Dearmoments/28_-/源码/stm32/readme.txt

本实验将实现如下功能：本实验为基于UCOSIII操作系统的STemWin的移植，我们使用UCOSII来为STemWin提供系统时钟，建立一个任务来处理触摸屏。本实验通过移植官方的Demo来测试基于UCOSII的STemWin移植是否成功，本实验兼容2.8，3.5，4.3寸屏幕。

注意：本实验使用了UCOSII操作系统，使用了触摸屏！

            	广州市星翼电子科技有限公司

                电话：020-38271790

                传真：020-36773971

	       	购买：http://shop62103354.taobao.com

                      http://shop62057469.taobao.com

                公司网站：www.alientek.com

         	技术论坛：www.openedv.com
