Dearmoments/28_-/方案说明/方案说明.md

这个题主要难度在于测上升沿时间，用窗口比较器测的话进度难以保证，一是测幅会有误差，测幅误差会导致窗口电压存在误差，而比较器本身也不是理想比较器，这一系列误差、非理想情况造成的误差会积累，导致最后精度难以保证。这个方案对制作要求太高。。

我们这次用的方法是：ADC等效采样、脉冲的上升沿，根据上升沿的几个数据点求出上升沿斜率，根据脉冲幅值和斜率求出上升时间，这个方法还算靠谱，不”校准“的情况下精度即可达到要求。

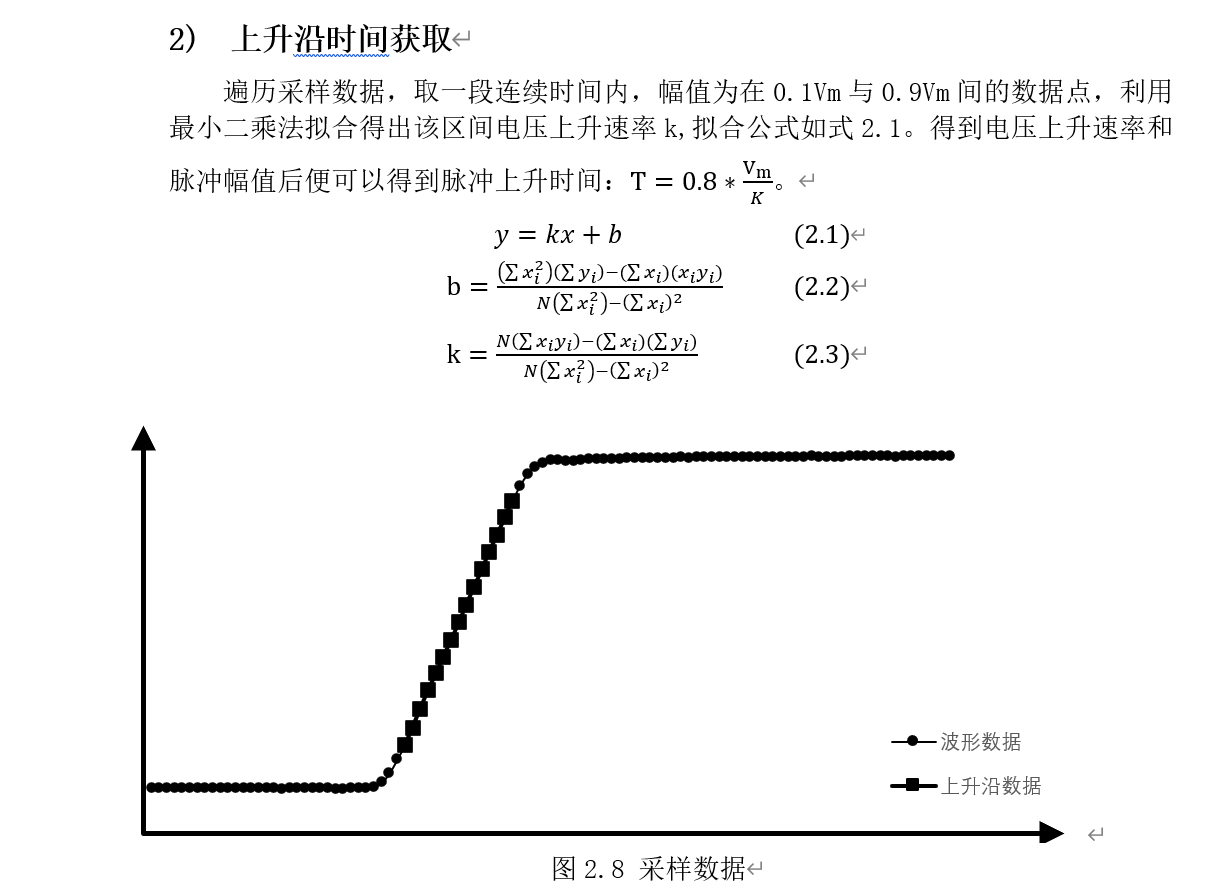
[picture p1: 方案说明/方案说明.assets/image-20200614181531141.png]
