Dearmoments/28_-/总结.docx

幅值测量：统计，取平均，会使结果稳定很多，几乎不跳动

上升时间测量：等效采样，拟合上升沿，求上升速率，再根据幅值算出上升时间，会准很多
