Dearmoments/28_-/图片/IMG_20190709_141804.jpg

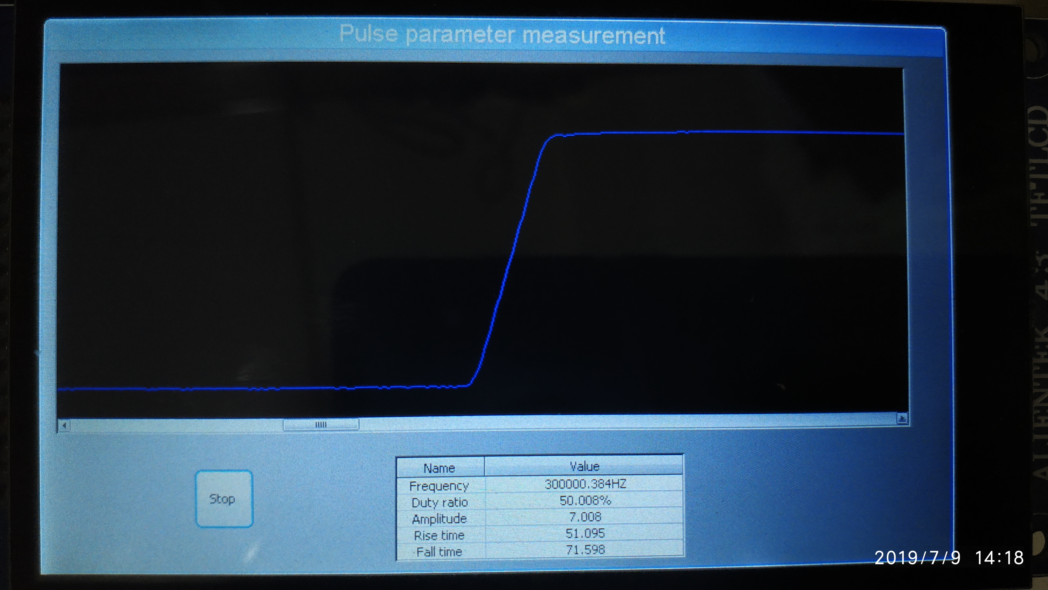
图片/IMG_20190709_141804.jpg
