Dearmoments/28_-/文档/脉冲参数测量硬件结构图-V1.1.pdf

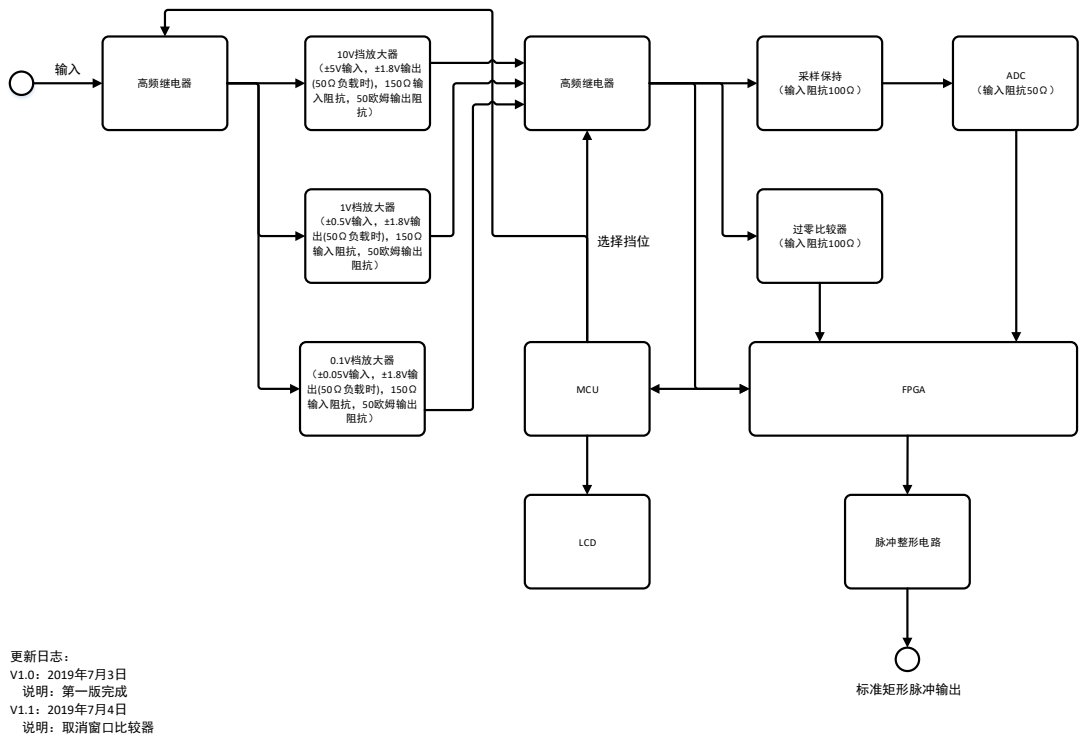
[picture p3: page 1]
10V挡放大器 （±5V输入，±1.8V输出 (50Ω负载时)，150Ω输 入阻抗，50欧姆输出阻 抗）; 1V档放大器 （±0.5V输入，±1.8V输 出(50Ω负载时)，150Ω 输入阻抗，50欧姆输出 阻抗）; 0.1V档放大器 （±0.05V输入，±1.8V输 出(50Ω负载时)，150Ω 输入阻抗，50欧姆输出 阻抗）; 高频继电器; 采样保持; （输入阻抗100Ω）; ADC （输入阻抗50Ω）; 过零比较器 （输入阻抗100Ω）; MCU; FPGA; LCD; 脉冲整形电路; 选择挡位; 标准矩形脉冲输出; 更新日志： V1.0：2019年7月3日 说明：第一版完成 V1.1：2019年7月4日 说明：取消窗口比较器
