Dearmoments/28_-/文档/脉冲参数测量硬件结构图-V1.2(最终版).pdf

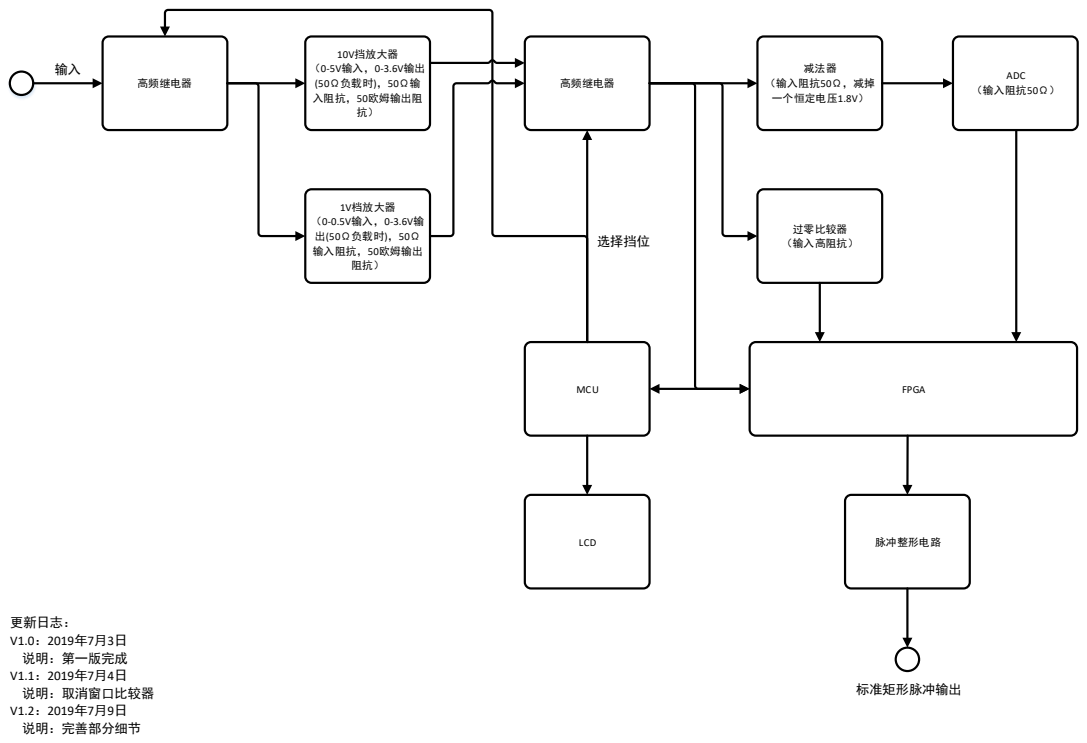
[picture p4: page 1]
10V挡放大器 （0-5V输入，0-3.6V输出 (50Ω负载时)，50Ω输 入阻抗，50欧姆输出阻 抗）; 1V档放大器 （0-0.5V输入，0-3.6V输 出(50Ω负载时)，50Ω 输入阻抗，50欧姆输出 阻抗）; 高频继电器; 减法器 （输入阻抗50Ω，减掉 一个恒定电压1.8V）; ADC （输入阻抗50Ω）; 过零比较器 （输入高阻抗）; MCU; FPGA; LCD; 脉冲整形电路; 选择挡位; 标准矩形脉冲输出; 更新日志： V1.0：2019年7月3日 说明：第一版完成 V1.1：2019年7月4日 说明：取消窗口比较器 V1.2：2019年7月9日 说明：完善部分细节
