Dearmoments/28_-/原理图/高速AD/PCB_Project/PCB_Project.pdf

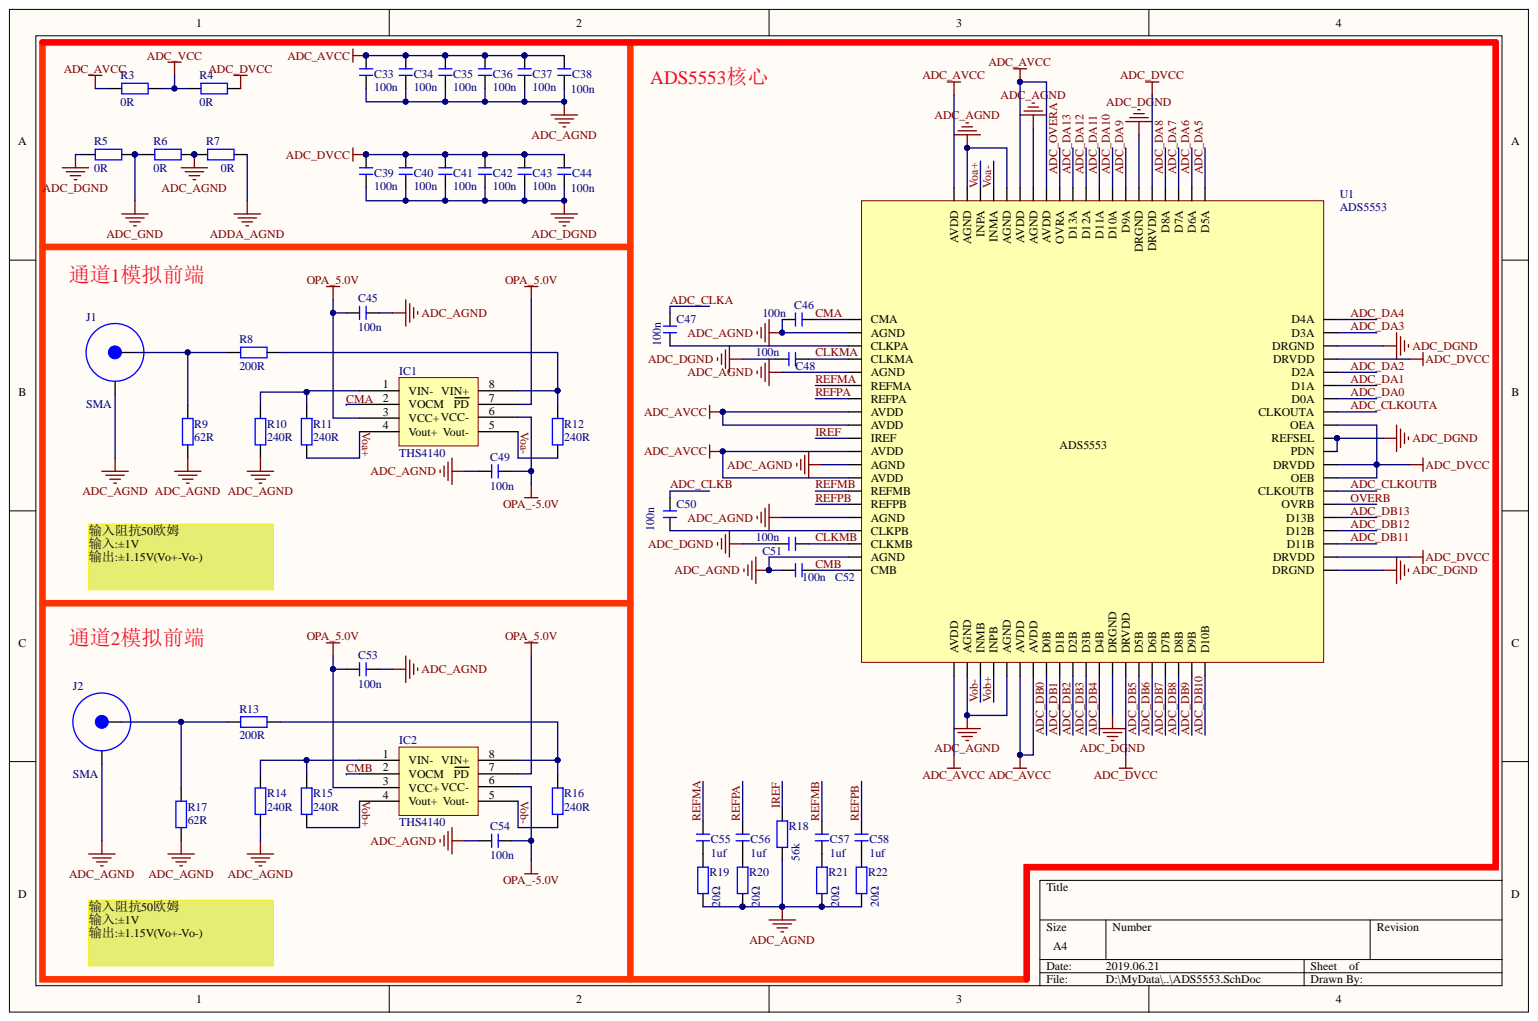
[picture p5: page 1]

CMB | VOCM 2

VCC+ 3

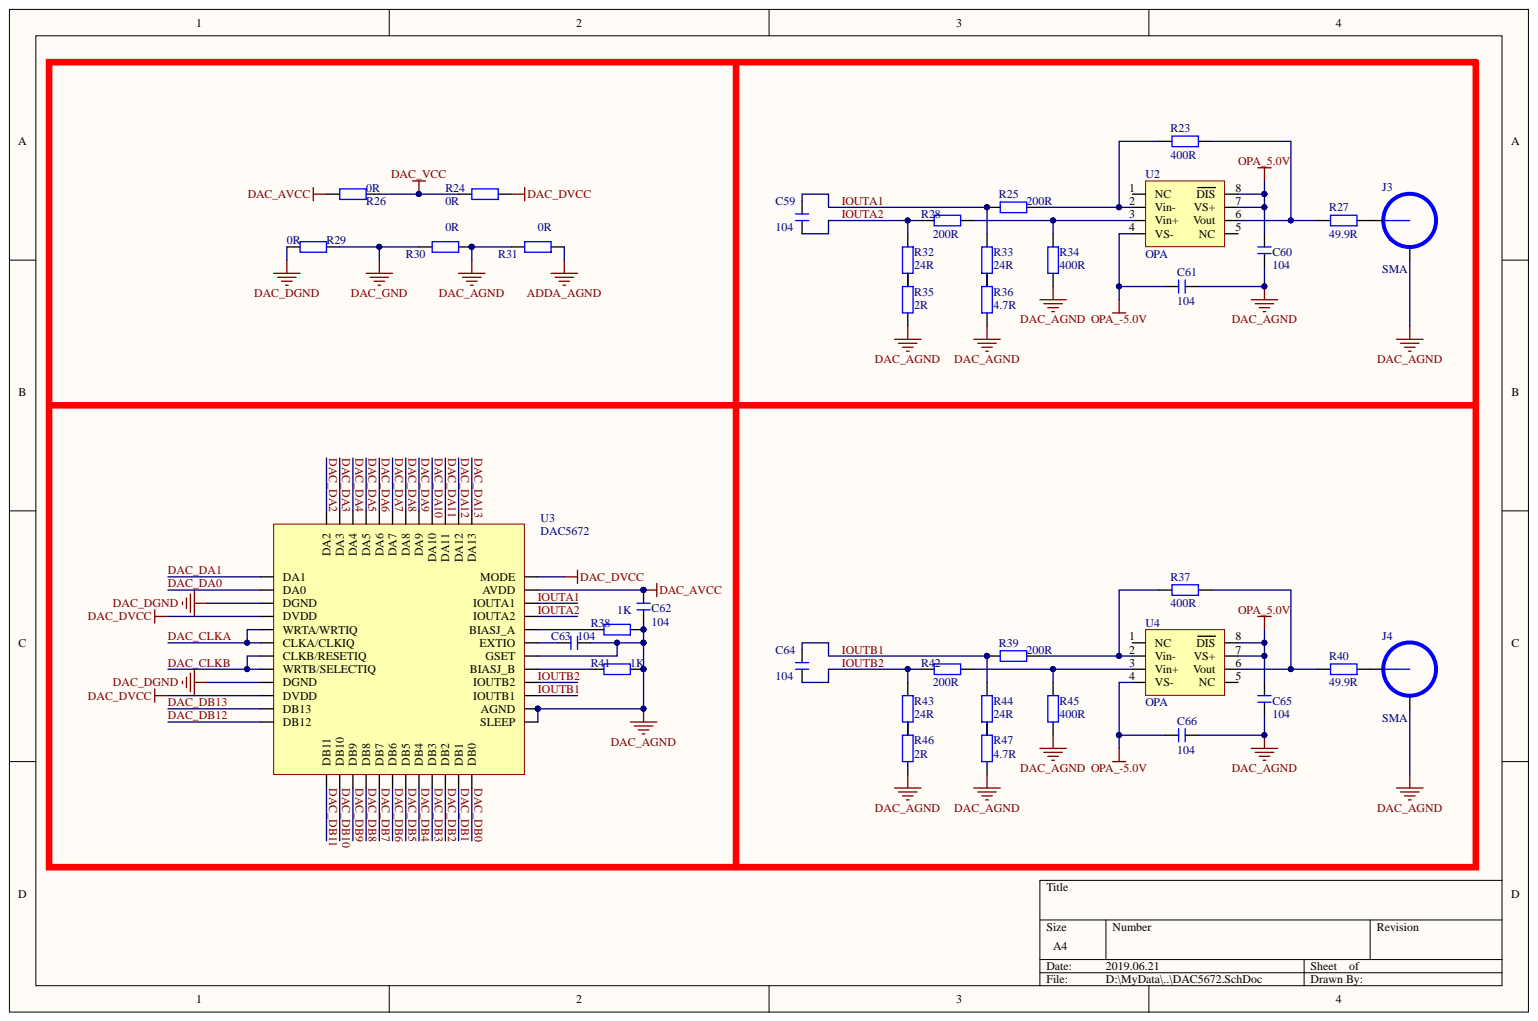
[picture p6: page 2]

DAC_VCC 0R | R23

U2 | | OPA_5.0V

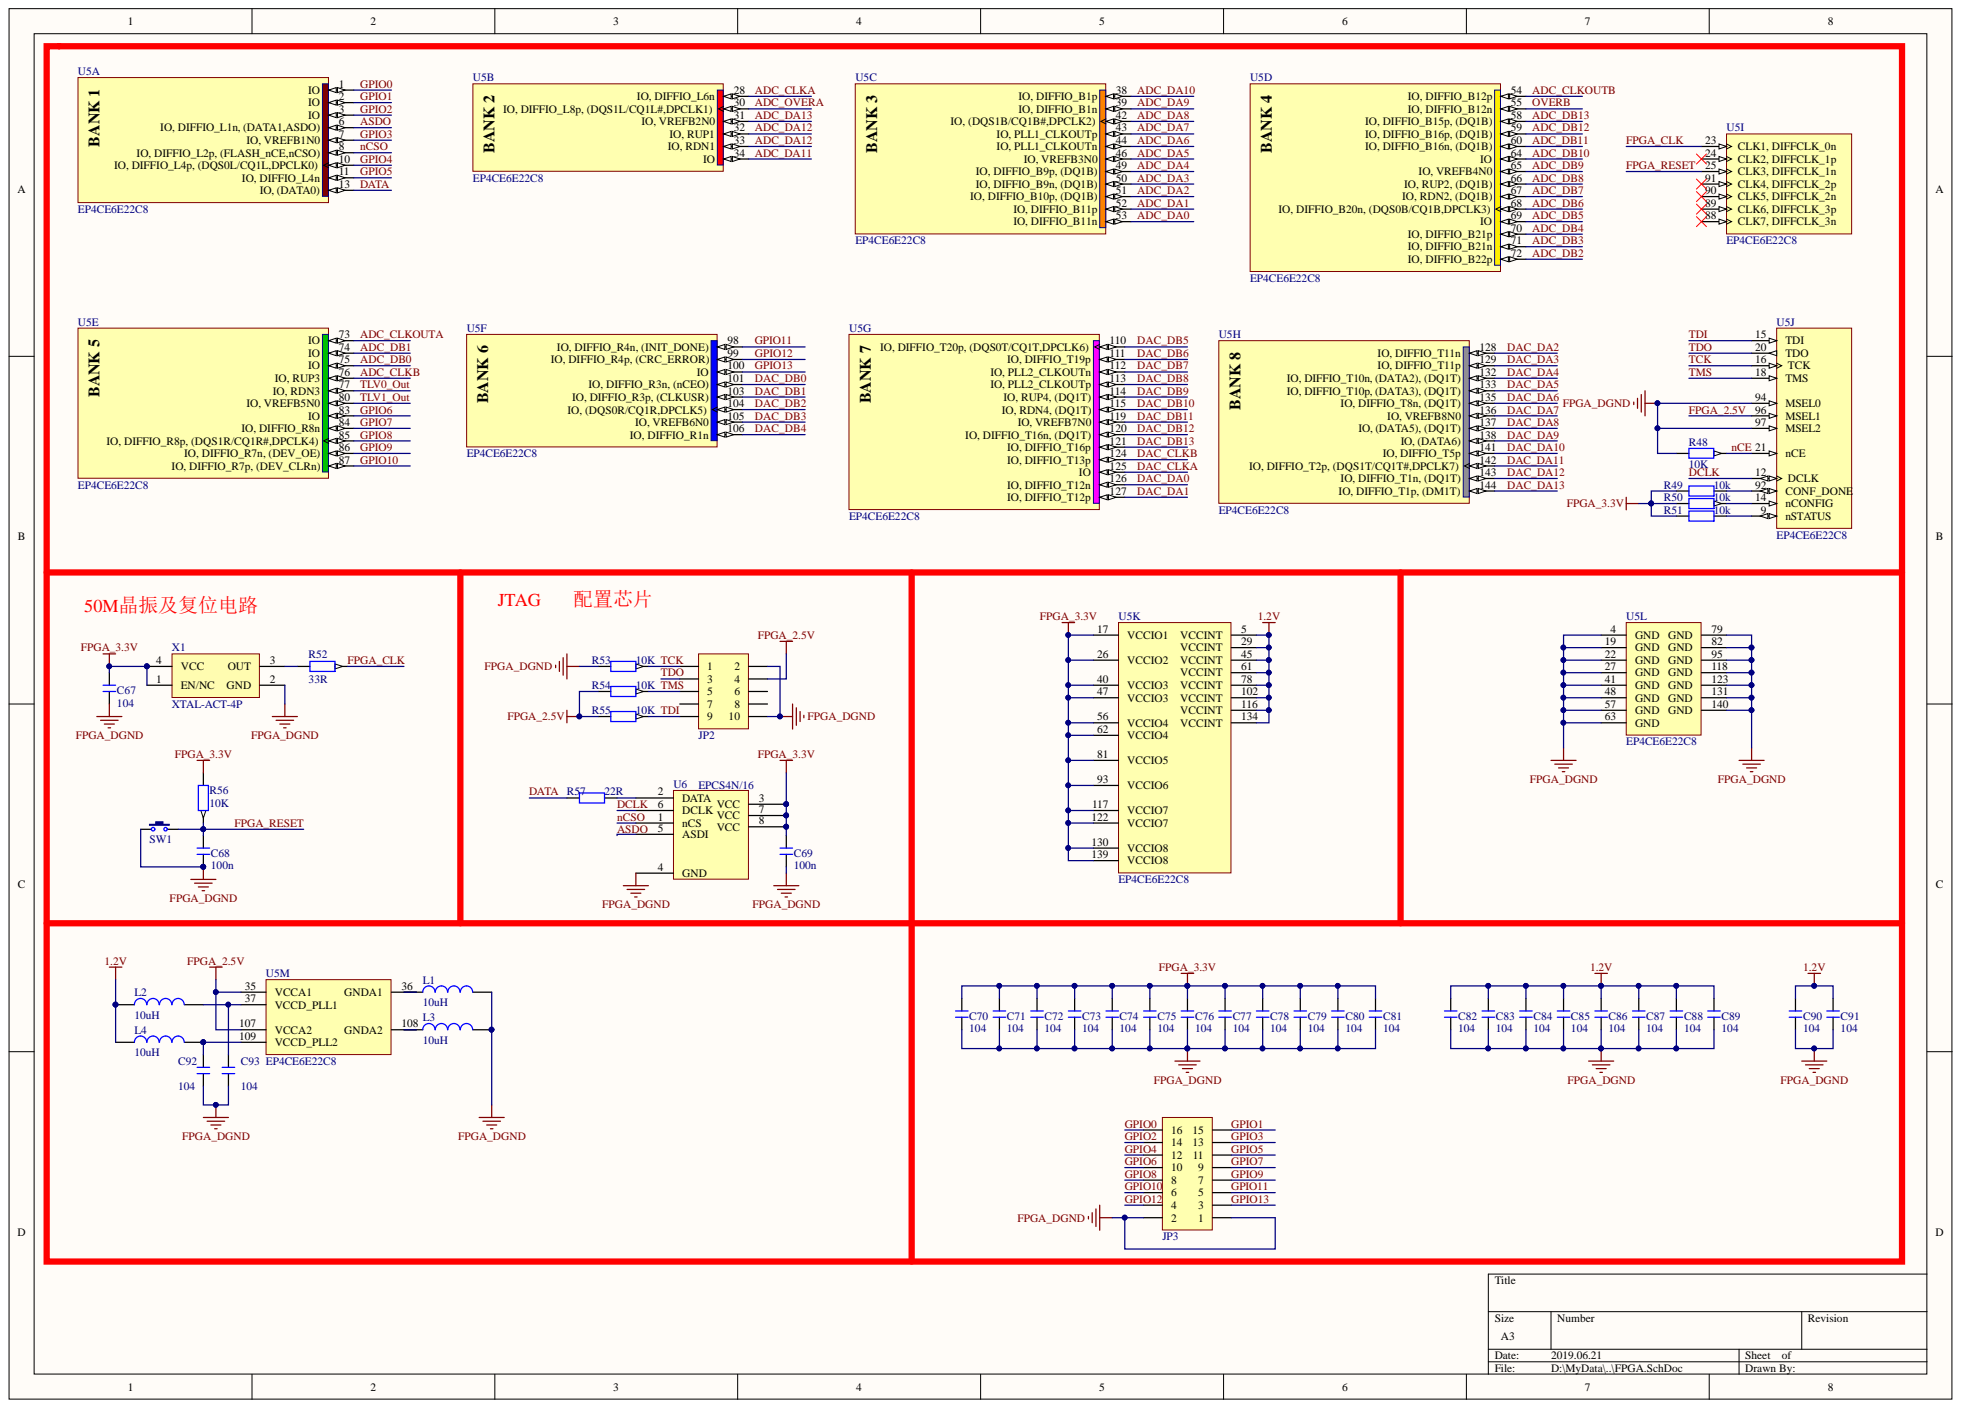
[picture p7: page 3]

VCCD_PLL1 37 VCCA2 107

VCCD_PLL2 109

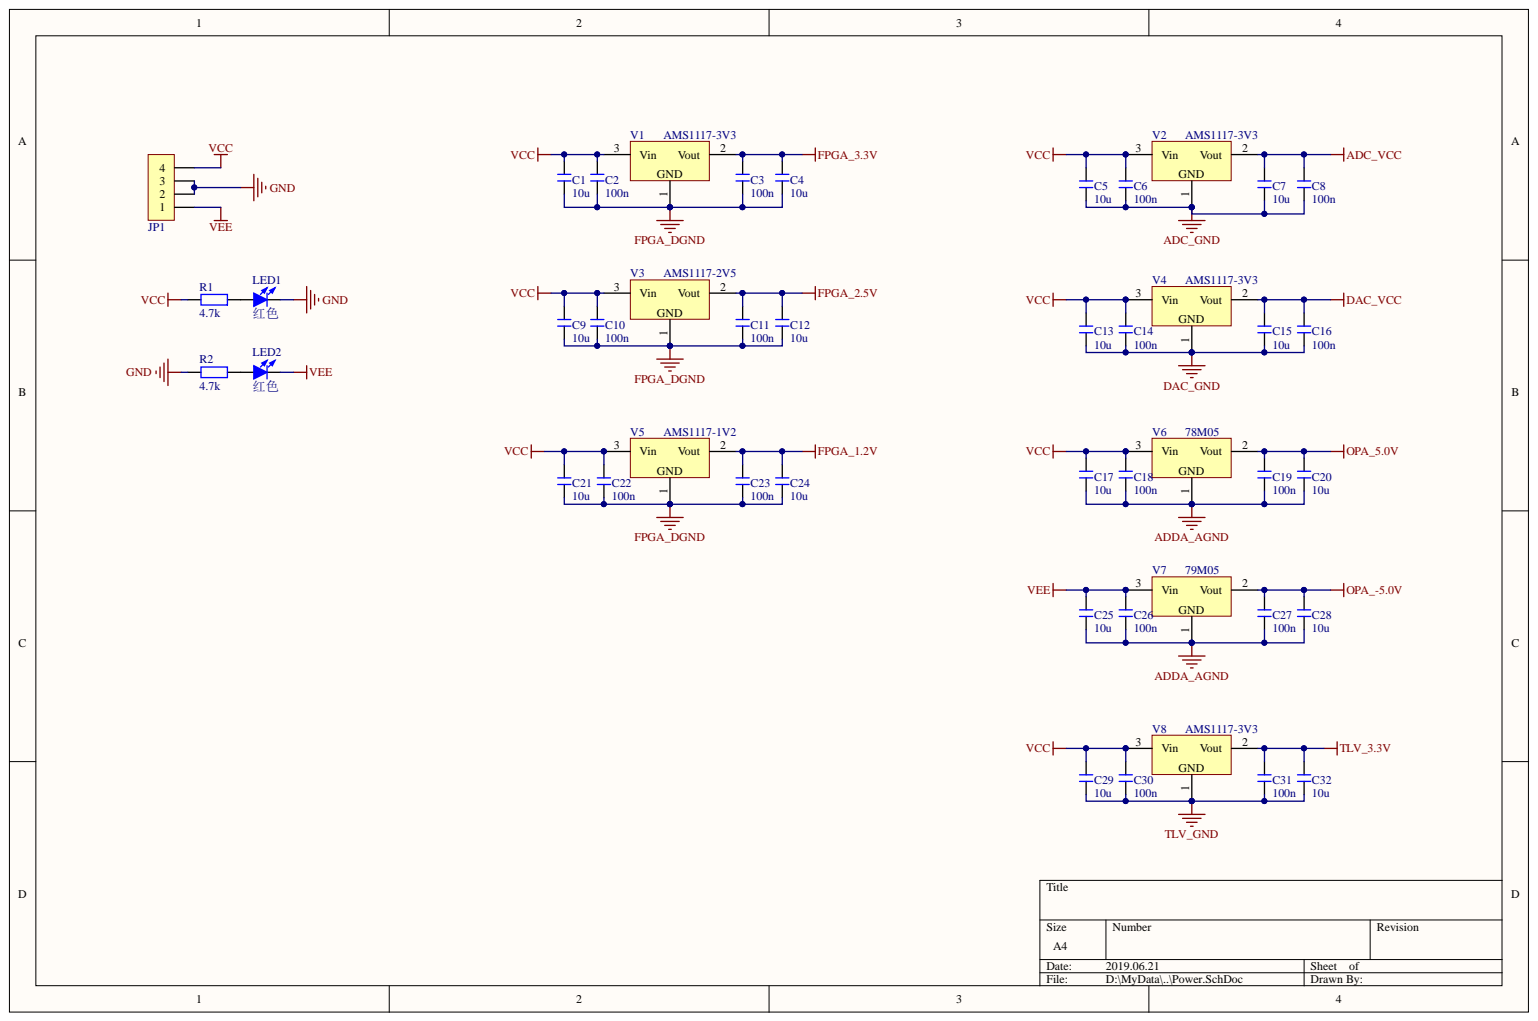
[picture p8: page 4]

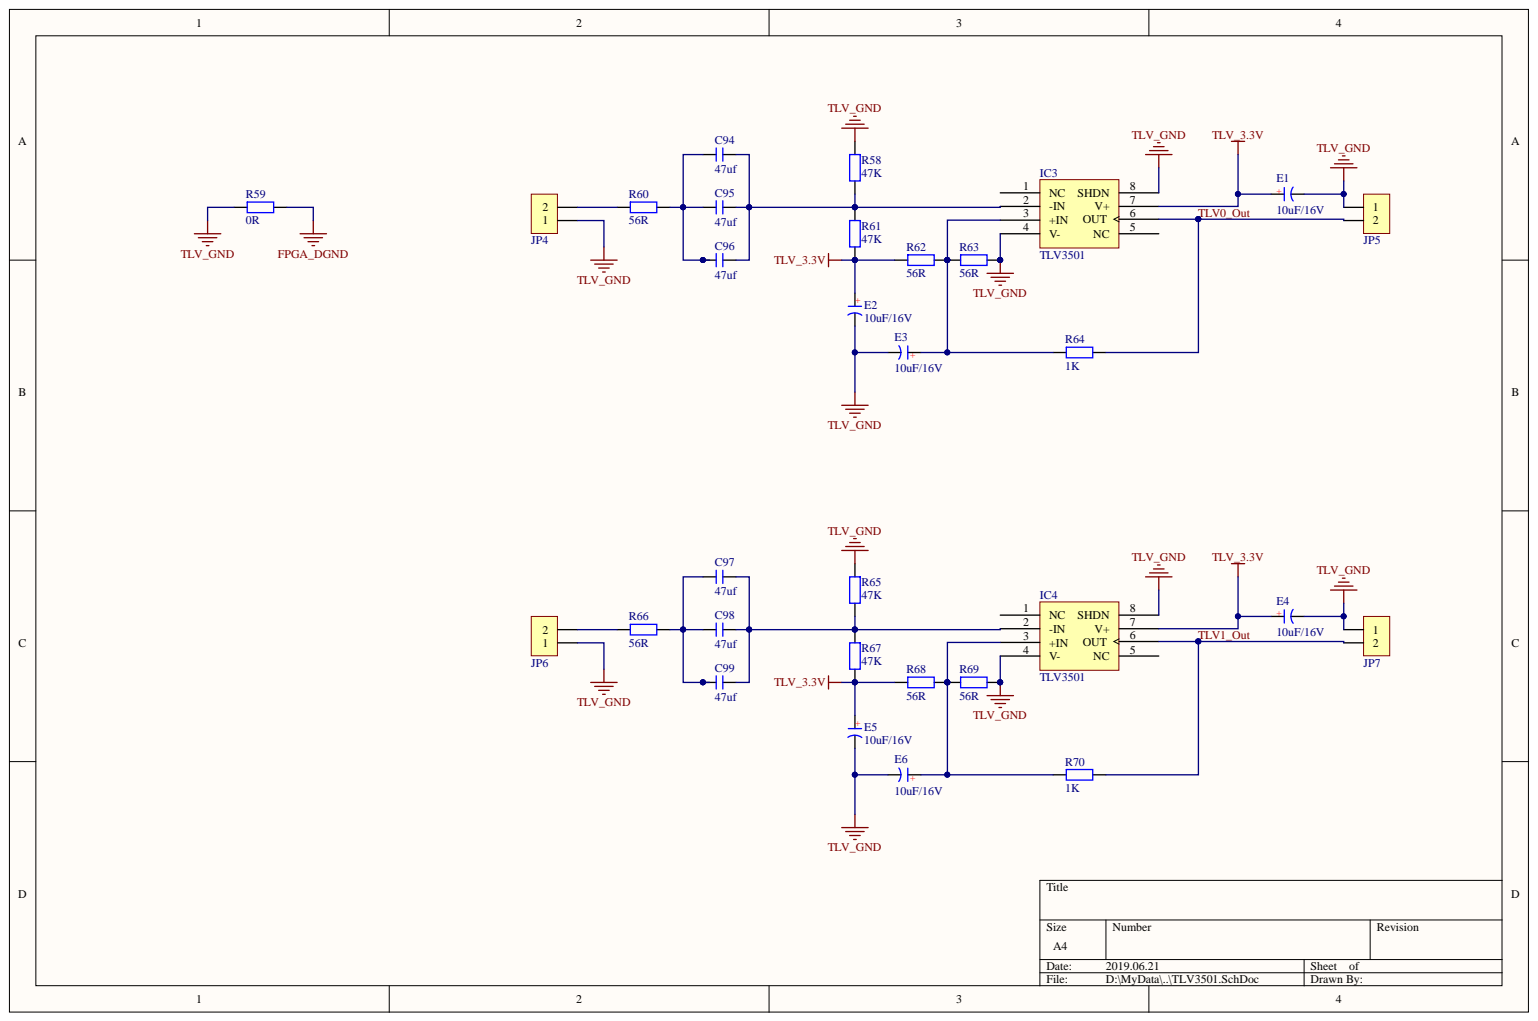
[picture p9: page 5]

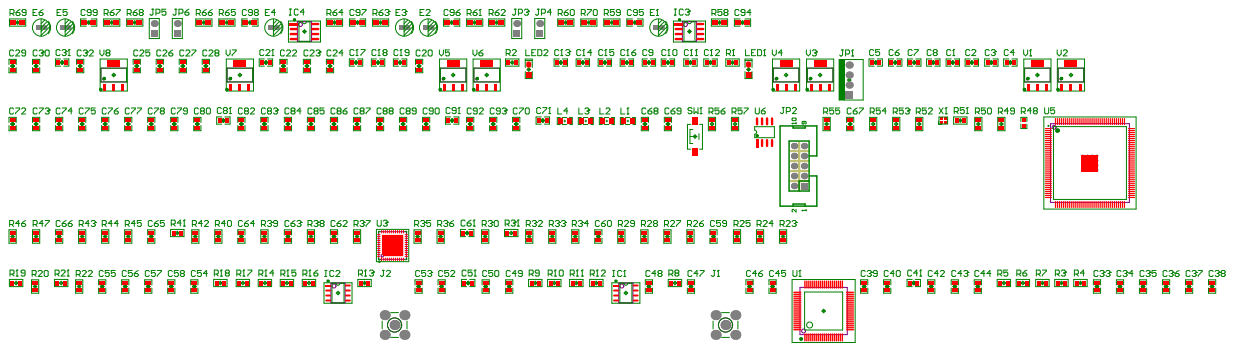
[picture p10: page 6]
