Dearmoments/28_-/原理图/ARE134H_Project/123.pdf

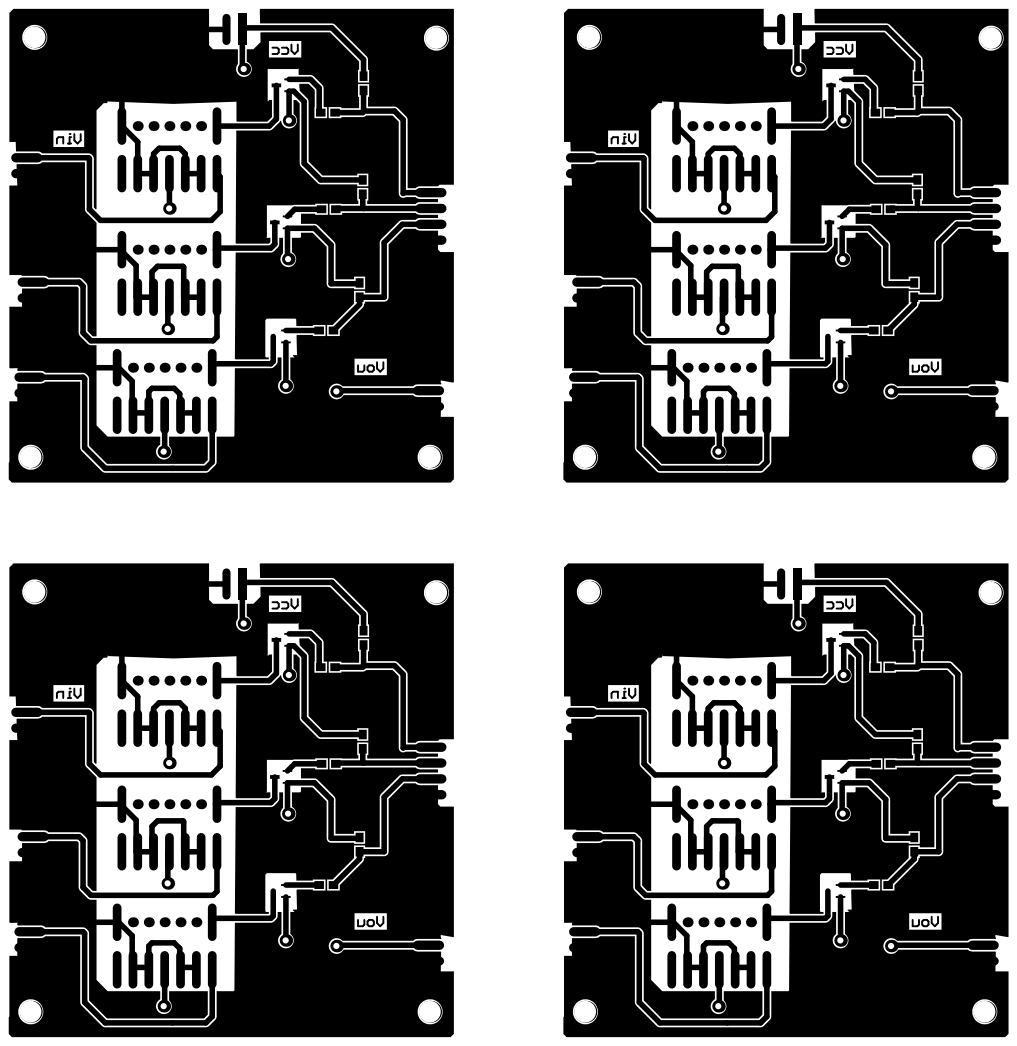
[picture p11: page 1]
