Dearmoments/28_-/(list of files, drawings)

Other design files:
原理图/AD_Student_018(TLV3501)/PCB_Project/PCB1.PcbDoc
原理图/AD_Student_018(TLV3501)/PCB_Project/PCB2.PcbDoc
原理图/AD_Student_018(TLV3501)/PCB_Project/PCB_Project.PrjPcb
原理图/AD_Student_018(TLV3501)/PCB_Project/Sheet1.SchDoc
原理图/AD_Student_021(AMP)/PCB_Project/AMP.PcbDoc
原理图/AD_Student_021(AMP)/PCB_Project/AMP.SchDoc
原理图/AD_Student_021(AMP)/PCB_Project/AMPS.PcbDoc
原理图/AD_Student_021(AMP)/PCB_Project/PCB_Project.PrjPcb
原理图/AD_Student_021(AMP)/PCB_Project/电子竞赛.SchLib
原理图/AD_Student_022(拉低1.8V)/PCB_Project/PCB_Project.PrjPcb
原理图/AD_Student_022(拉低1.8V)/PCB_Project/拉低1.8V.PcbDoc
原理图/AD_Student_022(拉低1.8V)/PCB_Project/拉低1.8V.SchDoc
原理图/AD_Student_022(拉低1.8V)/PCB_Project/拉低1.8VS.PcbDoc
原理图/ARE134H_Project/ARE134H.PcbDoc
原理图/ARE134H_Project/ARE134H.SchDoc
原理图/ARE134H_Project/ARE134H.SchLib
原理图/ARE134H_Project/ARE134H_Project.PrjPcb
原理图/ARE134H_Project/PCB1.PcbDoc
原理图/高速AD/PCB_Project/ADS5553.SchDoc
原理图/高速AD/PCB_Project/DAC5672.SchDoc
原理图/高速AD/PCB_Project/FPAG2.SchDoc
原理图/高速AD/PCB_Project/FPGA.SchDoc
原理图/高速AD/PCB_Project/PCB_Project.PrjPcb
原理图/高速AD/PCB_Project/Power.SchDoc
原理图/高速AD/PCB_Project/TLV3501.SchDoc
原理图/高速AD/PCB_Project/TopMod.SchDoc
原理图/高速AD/PCB_Project/电子竞赛.PcbLib
原理图/高速AD/PCB_Project/电子竞赛.SchLib
