Dearmoments/28_-/源码/stm32/USER/DOSDLG.c

/*********************************************************************
*                                                                    *
*                SEGGER Microcontroller GmbH & Co. KG                *
*        Solutions for real time microcontroller applications        *
*                                                                    *
**********************************************************************
*                                                                    *
* C-file generated by:                                               *
*                                                                    *
*        GUI_Builder for emWin version 5.26                          *
*        Compiled Aug 18 2014, 17:12:05                              *
*        (c) 2014 Segger Microcontroller GmbH & Co. KG               *
*                                                                    *
**********************************************************************
*                                                                    *
*        Internet: www.segger.com  Support: support@segger.com       *
*                                                                    *
**********************************************************************
*/

// USER START (Optionally insert additional includes)
#include "DAC8560.h"
// USER END

#include "DIALOG.h"

/*********************************************************************
*
*       Defines
*
**********************************************************************
*/
#define ID_FRAMEWIN_0     (GUI_ID_USER + 0x0F)
#define ID_GRAPH_0     (GUI_ID_USER + 0x11)
#define ID_BUTTON_0     (GUI_ID_USER + 0x12)
#define ID_BUTTON_1     (GUI_ID_USER + 0x13)
#define ID_LISTVIEW_0     (GUI_ID_USER + 0x18)
#define ID_BUTTON_2     (GUI_ID_USER + 0x19)
#define ID_BUTTON_3     (GUI_ID_USER + 0x1A)
#define ID_CHECKBOX_0     (GUI_ID_USER + 0x1D)
#define ID_RADIO_0     (GUI_ID_USER + 0x1E)
#define ID_RADIO_1     (GUI_ID_USER + 0x1F)
#define ID_RADIO_2     (GUI_ID_USER + 0x20)
#define ID_SLIDER_0     (GUI_ID_USER + 0x21)


// USER START (Optionally insert additional defines)
// USER END

/*********************************************************************
*
*       Static data
*
**********************************************************************
*/

// USER START (Optionally insert additional static data)
// USER END

/*********************************************************************
*
*       _aDialogCreate
*/
static const GUI_WIDGET_CREATE_INFO _aDialogCreate[] = {
  { FRAMEWIN_CreateIndirect, "DOS", ID_FRAMEWIN_0, 0, 0, 800, 480, 0, 0x0, 0 },
  { GRAPH_CreateIndirect, "Graph", ID_GRAPH_0, 10, 10, 743, 360, 0, 0x0, 0 },
  { BUTTON_CreateIndirect, "Run", ID_BUTTON_0, 20, 385, 50, 50, 0, 0x0, 0 },
  { BUTTON_CreateIndirect, "Single", ID_BUTTON_1, 90, 385, 50, 50, 0, 0x0, 0 },
  { LISTVIEW_CreateIndirect, "Listview", ID_LISTVIEW_0, 325, 380, 150, 60, 0, 0x0, 0 },
  { BUTTON_CreateIndirect, "Store", ID_BUTTON_2, 500, 385, 50, 50, 0, 0x0, 0 },
  { BUTTON_CreateIndirect, "Replay", ID_BUTTON_3, 570, 385, 50, 50, 0, 0x0, 0 },
  { CHECKBOX_CreateIndirect, "CalOutEnbale", ID_CHECKBOX_0, 640, 400, 80, 20, 0, 0x0, 0 },
  { RADIO_CreateIndirect, "Radio", ID_RADIO_0, 160, 380, 80, 60, 0, 0x1403, 0 },
  { RADIO_CreateIndirect, "Radio", ID_RADIO_1, 240, 380, 80, 60, 0, 0x1403, 0 },
  { RADIO_CreateIndirect, "Radio", ID_RADIO_2, 715, 392, 66, 40, 0, 0x1402, 0 },
  { SLIDER_CreateIndirect, "Slider", ID_SLIDER_0, 761, 30, 20, 320, 8, 0x0, 0 },
  // USER START (Optionally insert additional widgets)
  // USER END
};

/*********************************************************************
*
*       Static code
*
**********************************************************************
*/

// USER START (Optionally insert additional static code)
// USER END

/*********************************************************************
*
*       _cbDialog
*/
static void _cbDialog(WM_MESSAGE * pMsg) {
  WM_HWIN hItem;
  int     NCode;
  int     Id;
  // USER START (Optionally insert additional variables)
  int value;
  // USER END

  switch (pMsg->MsgId) {
  case WM_INIT_DIALOG:
    //
    // Initialization of 'DOS'
    //
    hItem = pMsg->hWin;
    FRAMEWIN_SetTextAlign(hItem, GUI_TA_HCENTER | GUI_TA_VCENTER);
    FRAMEWIN_SetFont(hItem, GUI_FONT_24_ASCII);
    //
    // Initialization of 'Listview'
    //
    hItem = WM_GetDialogItem(pMsg->hWin, ID_LISTVIEW_0);
    LISTVIEW_AddColumn(hItem, 40, "Name", GUI_TA_HCENTER | GUI_TA_VCENTER);
    LISTVIEW_AddColumn(hItem, 110, "Col 1", GUI_TA_HCENTER | GUI_TA_VCENTER);
    LISTVIEW_AddRow(hItem, NULL);
    LISTVIEW_SetGridVis(hItem, 1);
    //
    // Initialization of 'CalOutEnbale'
    //
    hItem = WM_GetDialogItem(pMsg->hWin, ID_CHECKBOX_0);
    CHECKBOX_SetText(hItem, "CAL OUT");
    //
    // Initialization of 'Radio'
    //
    hItem = WM_GetDialogItem(pMsg->hWin, ID_RADIO_0);
    RADIO_SetText(hItem, "1v/div", 0);
    RADIO_SetText(hItem, "0.1v/div", 1);
    RADIO_SetText(hItem, "2mv/div", 2);
    //
    // Initialization of 'Radio'
    //
    hItem = WM_GetDialogItem(pMsg->hWin, ID_RADIO_1);
    RADIO_SetText(hItem, "20ms/div", 0);
    RADIO_SetText(hItem, "2us/div", 1);
    RADIO_SetText(hItem, "100ns/div", 2);
    //
    // Initialization of 'Radio'
    //
    hItem = WM_GetDialogItem(pMsg->hWin, ID_RADIO_2);
    RADIO_SetText(hItem, "RTSamp", 0);
    RADIO_SetText(hItem, "EquSamp", 1);
    // USER START (Optionally insert additional code for further widget initialization)
    hItem = WM_GetDialogItem(pMsg->hWin,ID_GRAPH_0);
    GRAPH_SetColor(hItem,GUI_WHITE,GRAPH_CI_BK);
    // USER END
    break;
  case WM_NOTIFY_PARENT:
    Id    = WM_GetId(pMsg->hWinSrc);
    NCode = pMsg->Data.v;
    switch(Id) {
    case ID_BUTTON_0: // Notifications sent by 'Run'
      switch(NCode) {
      case WM_NOTIFICATION_CLICKED:
        // USER START (Optionally insert code for reacting on notification message)
        // USER END
        break;
      case WM_NOTIFICATION_RELEASED:
        // USER START (Optionally insert code for reacting on notification message)
        hItem=WM_GetDialogItem(pMsg->hWin,ID_BUTTON_0);
        BUTTON_SetText(hItem,"Stop");
        // USER END
        break;
      // USER START (Optionally insert additional code for further notification handling)
      // USER END
      }
      break;
    case ID_BUTTON_1: // Notifications sent by 'Single'
      switch(NCode) {
      case WM_NOTIFICATION_CLICKED:
        // USER START (Optionally insert code for reacting on notification message)
        // USER END
        break;
      case WM_NOTIFICATION_RELEASED:
        // USER START (Optionally insert code for reacting on notification message)
        // USER END
        break;
      // USER START (Optionally insert additional code for further notification handling)
      // USER END
      }
      break;
    case ID_LISTVIEW_0: // Notifications sent by 'Listview'
      switch(NCode) {
      case WM_NOTIFICATION_CLICKED:
        // USER START (Optionally insert code for reacting on notification message)
        // USER END
        break;
      case WM_NOTIFICATION_RELEASED:
        // USER START (Optionally insert code for reacting on notification message)
        // USER END
        break;
      case WM_NOTIFICATION_SEL_CHANGED:
        // USER START (Optionally insert code for reacting on notification message)
        // USER END
        break;
      // USER START (Optionally insert additional code for further notification handling)
      // USER END
      }
      break;
    case ID_BUTTON_2: // Notifications sent by 'Store'
      switch(NCode) {
      case WM_NOTIFICATION_CLICKED:
        // USER START (Optionally insert code for reacting on notification message)
        // USER END
        break;
      case WM_NOTIFICATION_RELEASED:
        // USER START (Optionally insert code for reacting on notification message)
        // USER END
        break;
      // USER START (Optionally insert additional code for further notification handling)
      // USER END
      }
      break;
    case ID_BUTTON_3: // Notifications sent by 'Replay'
      switch(NCode) {
      case WM_NOTIFICATION_CLICKED:
        // USER START (Optionally insert code for reacting on notification message)
        // USER END
        break;
      case WM_NOTIFICATION_RELEASED:
        // USER START (Optionally insert code for reacting on notification message)
        // USER END
        break;
      // USER START (Optionally insert additional code for further notification handling)
      // USER END
      }
      break;
    case ID_CHECKBOX_0: // Notifications sent by 'CalOutEnbale'
      switch(NCode) {
      case WM_NOTIFICATION_CLICKED:
        // USER START (Optionally insert code for reacting on notification message)
        // USER END
        break;
      case WM_NOTIFICATION_RELEASED:
        // USER START (Optionally insert code for reacting on notification message)
        // USER END
        break;
      case WM_NOTIFICATION_VALUE_CHANGED:
        // USER START (Optionally insert code for reacting on notification message)
        // USER END
        break;
      // USER START (Optionally insert additional code for further notification handling)
      // USER END
      }
      break;
    case ID_RADIO_0: // Notifications sent by 'Radio'
      switch(NCode) {
      case WM_NOTIFICATION_CLICKED:
        // USER START (Optionally insert code for reacting on notification message)
        // USER END
        break;
      case WM_NOTIFICATION_RELEASED:
        // USER START (Optionally insert code for reacting on notification message)
        // USER END
        break;
      case WM_NOTIFICATION_VALUE_CHANGED:
        // USER START (Optionally insert code for reacting on notification message)
        // USER END
        break;
      // USER START (Optionally insert additional code for further notification handling)
      // USER END
      }
      break;
    case ID_RADIO_1: // Notifications sent by 'Radio'
      switch(NCode) {
      case WM_NOTIFICATION_CLICKED:
        // USER START (Optionally insert code for reacting on notification message)
        // USER END
        break;
      case WM_NOTIFICATION_RELEASED:
        // USER START (Optionally insert code for reacting on notification message)
        // USER END
        break;
      case WM_NOTIFICATION_VALUE_CHANGED:
        // USER START (Optionally insert code for reacting on notification message)
        // USER END
        break;
      // USER START (Optionally insert additional code for further notification handling)
      // USER END
      }
      break;
    case ID_RADIO_2: // Notifications sent by 'Radio'
      switch(NCode) {
      case WM_NOTIFICATION_CLICKED:
        // USER START (Optionally insert code for reacting on notification message)
        // USER END
        break;
      case WM_NOTIFICATION_RELEASED:
        // USER START (Optionally insert code for reacting on notification message)
        // USER END
        break;
      case WM_NOTIFICATION_VALUE_CHANGED:
        // USER START (Optionally insert code for reacting on notification message)
        // USER END
        break;
      // USER START (Optionally insert additional code for further notification handling)
      // USER END
      }
      break;
    case ID_SLIDER_0: // Notifications sent by 'Slider'
      switch(NCode) {
      case WM_NOTIFICATION_CLICKED:
        // USER START (Optionally insert code for reacting on notification message)
        // USER END
        break;
      case WM_NOTIFICATION_RELEASED:
        // USER START (Optionally insert code for reacting on notification message)
        // USER END
        break;
      case WM_NOTIFICATION_VALUE_CHANGED:
        // USER START (Optionally insert code for reacting on notification message)
        value=SLIDER_GetValue(pMsg->hWinSrc);
        DAC8560_SetData(value/100.0*26214);
        // USER END
        break;
      // USER START (Optionally insert additional code for further notification handling)
      // USER END
      }
      break;
    // USER START (Optionally insert additional code for further Ids)
    // USER END
    }
    break;
  // USER START (Optionally insert additional message handling)
  // USER END
  default:
    WM_DefaultProc(pMsg);
    break;
  }
}

/*********************************************************************
*
*       Public code
*
**********************************************************************
*/
/*********************************************************************
*
*       CreateDOS
*/
WM_HWIN CreateDOS(void);
WM_HWIN CreateDOS(void) {
  WM_HWIN hWin;

  hWin = GUI_CreateDialogBox(_aDialogCreate, GUI_COUNTOF(_aDialogCreate), _cbDialog, WM_HBKWIN, 0, 0);
  return hWin;
}

// USER START (Optionally insert additional public code)
// USER END

/*************************** End of file ****************************/
