Dearmoments/28_-/源码/stm32/HARDWARE/KEY/key.h

#ifndef _KEY_H

#define _KEY_H

#include "sys.h"



//////////////////////////////////////////////////////////////////////////////////	 

//本程序只供学习使用，未经作者许可，不得用于其它任何用途

//ALIENTEK STM32F407开发板

//按键输入驱动代码	   

//正点原子@ALIENTEK

//技术论坛:www.openedv.com

//创建日期:2014/5/3

//版本：V1.0

//版权所有，盗版必究。

//Copyright(C) 广州市星翼电子科技有限公司 2014-2024

//All rights reserved									  

////////////////////////////////////////////////////////////////////////////////// 	



#define KEY0	PEin(4)	//PE4

#define KEY1	PEin(3) //PE3

#define KEY2	PEin(2) //PE2

#define WK_UP	PAin(0) //PA0



#define KEY0_PRES	1

#define KEY1_PRES 2

#define KEY2_PRES	3

#define WKUP_PRES	4



void KEY_Init(void);  //IO初始化

u8 KEY_Scan(u8);    //按键扫描函数

#endif 
