Dearmoments/28_-/源码/stm32/HARDWARE/IIC/myiic.h

#ifndef _MYIIC_H

#define _MYIIC_H

#include "sys.h"

//////////////////////////////////////////////////////////////////////////////////	 

//本程序只供学习使用，未经作者许可，不得用于其它任何用途

//ALIENTEK STM32F407开发板

//IIC 驱动代码	   

//正点原子@ALIENTEK

//技术论坛:www.openedv.com

//创建日期:2014/7/16

//版本：V1.0

//版权所有，盗版必究。

//Copyright(C) 广州市星翼电子科技有限公司 2014-2024

//All rights reserved									  

////////////////////////////////////////////////////////////////////////////////// 	



//IO方向设置

#define SDA_IN() 		{GPIOB->MODER&=~(3<<(9*2));GPIOB->MODER|=0<<9*2;}	//PB9输入模式

#define SDA_OUT()  	{GPIOB->MODER&=~(3<<(9*2));GPIOB->MODER|=1<<9*2;} //PB9输出模式

//IO操作函数	 

#define IIC_SCL		PBout(8) //SCL

#define IIC_SDA		PBout(9) //SDA

#define READ_SDA	PBin(9)  //输入SDA



void IIC_Init(void);

void IIC_Start(void);

void IIC_Stop(void);

u8 IIC_Wait_Ack(void);

void IIC_Ack(void);

void IIC_NAck(void);

void IIC_Send_Byte(u8 txd);

u8 IIC_Read_Byte(unsigned char ack);



#endif
