Dearmoments/28_-/源码/stm32/UCOSIII/uCOS_CONFIG/app_cfg.h

#ifndef  APP_CFG_MODULE_PRESENT

#define  APP_CFG_MODULE_PRESENT





//任务开始优先级

#define  APP_CFG_TASK_START_PRIO                           2u



//任务堆栈大小

#define  APP_CFG_TASK_START_STK_SIZE                     128u

#define  APP_CFG_TASK_BLINKY_STK_SIZE                    128u



//任务堆栈限度

#define  APP_CFG_TASK_START_STK_SIZE_PCT_FULL             90u

#define  APP_CFG_TASK_START_STK_SIZE_LIMIT       (APP_CFG_TASK_START_STK_SIZE     * (100u - APP_CFG_TASK_START_STK_SIZE_PCT_FULL))    / 100u



#define  APP_CFG_TASK_BLINKY_STK_SIZE_LIMIT      (APP_CFG_TASK_BLINKY_STK_SIZE    * (100u - APP_CFG_TASK_START_STK_SIZE_PCT_FULL))    / 100u



//追踪和调试选项

#ifndef  TRACE_LEVEL_OFF

#define  TRACE_LEVEL_OFF                0

#endif



#ifndef  TRACE_LEVEL_INFO

#define  TRACE_LEVEL_INFO               1

#endif



#ifndef  TRACE_LEVEL_DBG

#define  TRACE_LEVEL_DBG                2

#endif



#define  APP_CFG_TRACE_LEVEL             TRACE_LEVEL_OFF

#define  APP_CFG_TRACE                   printf



#define  BSP_CFG_TRACE_LEVEL             TRACE_LEVEL_OFF

#define  BSP_CFG_TRACE                   printf



#define  APP_TRACE_INFO(x)               ((APP_CFG_TRACE_LEVEL >= TRACE_LEVEL_INFO)  ? (void)(APP_CFG_TRACE x) : (void)0)

#define  APP_TRACE_DBG(x)                ((APP_CFG_TRACE_LEVEL >= TRACE_LEVEL_DBG)   ? (void)(APP_CFG_TRACE x) : (void)0)



#define  BSP_TRACE_INFO(x)               ((BSP_CFG_TRACE_LEVEL  >= TRACE_LEVEL_INFO) ? (void)(BSP_CFG_TRACE x) : (void)0)

#define  BSP_TRACE_DBG(x)                ((BSP_CFG_TRACE_LEVEL  >= TRACE_LEVEL_DBG)  ? (void)(BSP_CFG_TRACE x) : (void)0)



#endif
