Dearmoments/28_-/源码/stm32/Tool/Sigma-Delta ADCDLG.c

/*********************************************************************
*                                                                    *
*                SEGGER Microcontroller GmbH & Co. KG                *
*        Solutions for real time microcontroller applications        *
*                                                                    *
**********************************************************************
*                                                                    *
* C-file generated by:                                               *
*                                                                    *
*        GUI_Builder for emWin version 5.26                          *
*        Compiled Aug 18 2014, 17:12:05                              *
*        (c) 2014 Segger Microcontroller GmbH & Co. KG               *
*                                                                    *
**********************************************************************
*                                                                    *
*        Internet: www.segger.com  Support: support@segger.com       *
*                                                                    *
**********************************************************************
*/

// USER START (Optionally insert additional includes)
// USER END

#include "DIALOG.h"

/*********************************************************************
*
*       Defines
*
**********************************************************************
*/
#define ID_FRAMEWIN_0   (GUI_ID_USER + 0x00)
#define ID_GRAPH_0   (GUI_ID_USER + 0x01)
#define ID_SLIDER_0   (GUI_ID_USER + 0x02)
#define ID_BUTTON_0   (GUI_ID_USER + 0x03)
#define ID_RADIO_0   (GUI_ID_USER + 0x04)
#define ID_TEXT_0   (GUI_ID_USER + 0x05)
#define ID_TEXT_1   (GUI_ID_USER + 0x06)
#define ID_TEXT_2   (GUI_ID_USER + 0x07)
#define ID_TEXT_3   (GUI_ID_USER + 0x08)
#define ID_TEXT_4   (GUI_ID_USER + 0x09)
#define ID_TEXT_5   (GUI_ID_USER + 0x0A)
#define ID_TEXT_6   (GUI_ID_USER + 0x0B)
#define ID_TEXT_7   (GUI_ID_USER + 0x0C)


// USER START (Optionally insert additional defines)
// USER END

/*********************************************************************
*
*       Static data
*
**********************************************************************
*/

// USER START (Optionally insert additional static data)
// USER END

/*********************************************************************
*
*       _aDialogCreate
*/
static const GUI_WIDGET_CREATE_INFO _aDialogCreate[] = {
  { FRAMEWIN_CreateIndirect, "Sigma-Delta ADC", ID_FRAMEWIN_0, 0, 0, 800, 480, 0, 0x0, 0 },
  { GRAPH_CreateIndirect, "Graph", ID_GRAPH_0, 5, 5, 780, 320, 0, 0x0, 0 },
  { SLIDER_CreateIndirect, "Slider", ID_SLIDER_0, 5, 325, 780, 30, 0, 0x0, 0 },
  { BUTTON_CreateIndirect, "Button", ID_BUTTON_0, 10, 370, 70, 70, 0, 0x0, 0 },
  { RADIO_CreateIndirect, "Radio", ID_RADIO_0, 94, 365, 120, 80, 0, 0x1404, 0 },
  { TEXT_CreateIndirect, "variance:", ID_TEXT_0, 250, 390, 50, 20, 0, 0x0, 0 },
  { TEXT_CreateIndirect, "VarianceTextbox", ID_TEXT_1, 299, 390, 80, 20, 0, 0x64, 0 },
  { TEXT_CreateIndirect, "data:", ID_TEXT_2, 350, 365, 50, 20, 0, 0x0, 0 },
  { TEXT_CreateIndirect, "DataTextbox", ID_TEXT_3, 400, 365, 80, 20, 0, 0x64, 0 },
  { TEXT_CreateIndirect, "voltage:", ID_TEXT_4, 350, 390, 50, 20, 0, 0x0, 0 },
  { TEXT_CreateIndirect, "VoltageTextbox", ID_TEXT_5, 400, 390, 80, 20, 0, 0x64, 0 },
  { TEXT_CreateIndirect, "X Position:", ID_TEXT_6, 350, 415, 50, 20, 0, 0x0, 0 },
  { TEXT_CreateIndirect, "XPositionTextBox", ID_TEXT_7, 400, 415, 80, 20, 0, 0x64, 0 },
  // USER START (Optionally insert additional widgets)
  // USER END
};

/*********************************************************************
*
*       Static code
*
**********************************************************************
*/

// USER START (Optionally insert additional static code)
// USER END

/*********************************************************************
*
*       _cbDialog
*/
static void _cbDialog(WM_MESSAGE * pMsg) {
  WM_HWIN hItem;
  int     NCode;
  int     Id;
  // USER START (Optionally insert additional variables)
  // USER END

  switch (pMsg->MsgId) {
  case WM_INIT_DIALOG:
    //
    // Initialization of 'Sigma-Delta ADC'
    //
    hItem = pMsg->hWin;
    FRAMEWIN_SetFont(hItem, GUI_FONT_16_ASCII);
    FRAMEWIN_SetTextAlign(hItem, GUI_TA_HCENTER | GUI_TA_VCENTER);
    //
    // Initialization of 'Radio'
    //
    hItem = WM_GetDialogItem(pMsg->hWin, ID_RADIO_0);
    RADIO_SetText(hItem, "mode1:100HZ  12Bit", 0);
    RADIO_SetText(hItem, "mode2:1600HZ 8Bit", 1);
    RADIO_SetText(hItem, "mode3:100HZ  16Bit", 2);
    RADIO_SetText(hItem, "mode4:1600HZ 16Bit", 3);
    //
    // Initialization of 'variance:'
    //
    hItem = WM_GetDialogItem(pMsg->hWin, ID_TEXT_0);
    TEXT_SetTextAlign(hItem, GUI_TA_LEFT | GUI_TA_VCENTER);
    //
    // Initialization of 'VarianceTextbox'
    //
    hItem = WM_GetDialogItem(pMsg->hWin, ID_TEXT_1);
    TEXT_SetTextAlign(hItem, GUI_TA_LEFT | GUI_TA_VCENTER);
    TEXT_SetText(hItem, "0");
    //
    // Initialization of 'data:'
    //
    hItem = WM_GetDialogItem(pMsg->hWin, ID_TEXT_2);
    TEXT_SetTextAlign(hItem, GUI_TA_RIGHT | GUI_TA_VCENTER);
    //
    // Initialization of 'DataTextbox'
    //
    hItem = WM_GetDialogItem(pMsg->hWin, ID_TEXT_3);
    TEXT_SetTextAlign(hItem, GUI_TA_LEFT | GUI_TA_VCENTER);
    TEXT_SetText(hItem, "0");
    //
    // Initialization of 'voltage:'
    //
    hItem = WM_GetDialogItem(pMsg->hWin, ID_TEXT_4);
    TEXT_SetTextAlign(hItem, GUI_TA_RIGHT | GUI_TA_VCENTER);
    //
    // Initialization of 'VoltageTextbox'
    //
    hItem = WM_GetDialogItem(pMsg->hWin, ID_TEXT_5);
    TEXT_SetTextAlign(hItem, GUI_TA_LEFT | GUI_TA_VCENTER);
    TEXT_SetText(hItem, "0");
    //
    // Initialization of 'X Position:'
    //
    hItem = WM_GetDialogItem(pMsg->hWin, ID_TEXT_6);
    TEXT_SetTextAlign(hItem, GUI_TA_RIGHT | GUI_TA_VCENTER);
    //
    // Initialization of 'XPositionTextBox'
    //
    hItem = WM_GetDialogItem(pMsg->hWin, ID_TEXT_7);
    TEXT_SetText(hItem, "0");
    TEXT_SetTextAlign(hItem, GUI_TA_LEFT | GUI_TA_VCENTER);
    // USER START (Optionally insert additional code for further widget initialization)
    // USER END
    break;
  case WM_NOTIFY_PARENT:
    Id    = WM_GetId(pMsg->hWinSrc);
    NCode = pMsg->Data.v;
    switch(Id) {
    case ID_SLIDER_0: // Notifications sent by 'Slider'
      switch(NCode) {
      case WM_NOTIFICATION_CLICKED:
        // USER START (Optionally insert code for reacting on notification message)
        // USER END
        break;
      case WM_NOTIFICATION_RELEASED:
        // USER START (Optionally insert code for reacting on notification message)
        // USER END
        break;
      case WM_NOTIFICATION_VALUE_CHANGED:
        // USER START (Optionally insert code for reacting on notification message)
        // USER END
        break;
      // USER START (Optionally insert additional code for further notification handling)
      // USER END
      }
      break;
    case ID_BUTTON_0: // Notifications sent by 'Button'
      switch(NCode) {
      case WM_NOTIFICATION_CLICKED:
        // USER START (Optionally insert code for reacting on notification message)
        // USER END
        break;
      case WM_NOTIFICATION_RELEASED:
        // USER START (Optionally insert code for reacting on notification message)
        // USER END
        break;
      // USER START (Optionally insert additional code for further notification handling)
      // USER END
      }
      break;
    case ID_RADIO_0: // Notifications sent by 'Radio'
      switch(NCode) {
      case WM_NOTIFICATION_CLICKED:
        // USER START (Optionally insert code for reacting on notification message)
        // USER END
        break;
      case WM_NOTIFICATION_RELEASED:
        // USER START (Optionally insert code for reacting on notification message)
        // USER END
        break;
      case WM_NOTIFICATION_VALUE_CHANGED:
        // USER START (Optionally insert code for reacting on notification message)
        // USER END
        break;
      // USER START (Optionally insert additional code for further notification handling)
      // USER END
      }
      break;
    // USER START (Optionally insert additional code for further Ids)
    // USER END
    }
    break;
  // USER START (Optionally insert additional message handling)
  // USER END
  default:
    WM_DefaultProc(pMsg);
    break;
  }
}

/*********************************************************************
*
*       Public code
*
**********************************************************************
*/
/*********************************************************************
*
*       CreateSigma-Delta ADC
*/
WM_HWIN CreateSigma-Delta ADC(void);
WM_HWIN CreateSigma-Delta ADC(void) {
  WM_HWIN hWin;

  hWin = GUI_CreateDialogBox(_aDialogCreate, GUI_COUNTOF(_aDialogCreate), _cbDialog, WM_HBKWIN, 0, 0);
  return hWin;
}

// USER START (Optionally insert additional public code)
// USER END

/*************************** End of file ****************************/
